Wbf200699-rgb/robei_car/little_car/source_review/57660ad3-9889-42e8-9674-7a41b4bae8d0.png

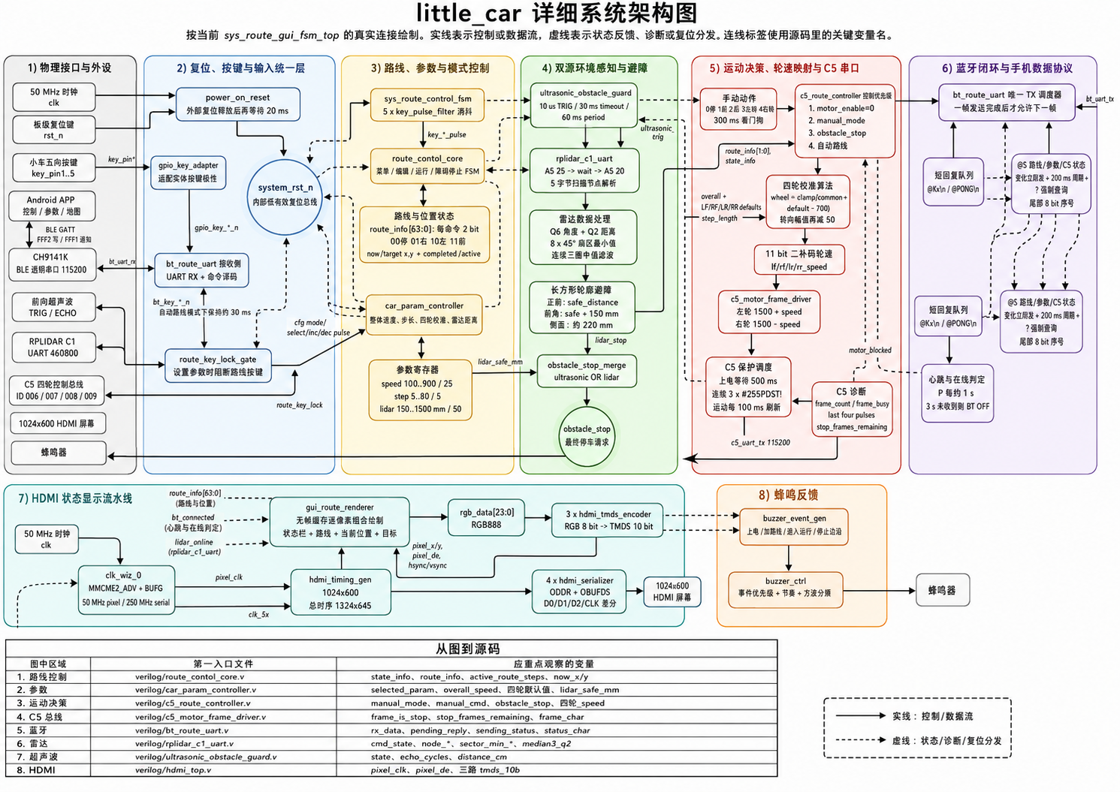
little_car/source_review/57660ad3-9889-42e8-9674-7a41b4bae8d0.png
