Wbf200699-rgb/robei_car/little_car/test_results/uwb_test_telemetry/20260805_123343_live_smoke.report.md

# UWB test telemetry report

> TEST ONLY: this capture is an engineering observation aid. It is not part of the competition architecture, score claim, or vehicle control/safety loop.

## Capture

- Source: `D:\Projects\Robei\little_car_new\little_car\test_results\uwb_test_telemetry\20260805_123343_live_smoke.jsonl`
- Samples: 26
- Duration: 4.999 s
- Effective sample rate: 5.001 Hz
- Gateway connected: 0.0%
- Gateway data fresh: 0.0%
- Four fresh valid tags: 0.0%
- Kinematics-valid samples: 0.0%
- Pose qualities: `{"none": 26}`
- Capture errors: 0 `{}`

## Motion

- Center path length: 0.000 cm
- Start-to-end displacement: 0.000 cm
- Speed median / p95 / max: -- / -- / -- cm/s
- Absolute yaw rate median / p95 / max: -- / -- / -- deg/s
- Fix skew median / p95 / max: -- / -- / -- ms

## Rectangle

| Edge | Median (cm) | P95 (cm) | Samples |
|---|---:|---:|---:|
| Front width | -- | -- | 0 |
| Rear width | -- | -- | 0 |
| Left length | -- | -- | 0 |
| Right length | -- | -- | 0 |

## Tag quality

| Tag | Fresh | Usable | Median X/Y (cm) | RMS radius (cm) | P95 radius (cm) |
|---:|---:|---:|---:|---:|---:|
| 0 | 0.0% | 0.0% | -- / -- | -- | -- |
| 1 | 0.0% | 0.0% | -- / -- | -- | -- |
| 2 | 0.0% | 0.0% | -- / -- | -- | -- |
| 3 | 0.0% | 0.0% | -- / -- | -- | -- |

The radius values are stationary jitter only when the vehicle remained stationary for the entire capture.

## Gateway counters

| Counter | Start | End | Accumulated delta | Resets |
|---|---:|---:|---:|---:|
| `good_frames` | 0 | 0 | 0 | 0 |
| `crc_errors` | 0 | 0 | 0 | 0 |
| `uwb_tx` | 1801 | 1801 | 0 | 0 |
| `queue_drops` | 0 | 0 | 0 | 0 |
| `rx_bytes` | 1 | 1 | 0 | 0 |
| `framing_errors` | 0 | 0 | 0 | 0 |
| `position_frames` | 0 | 0 | 0 | 0 |
| `pass_frames` | 0 | 0 | 0 | 0 |
| `raw_frames` | 0 | 0 | 0 | 0 |
| `position_start_requests` | 1801 | 1801 | 0 | 0 |

## Warnings

- Capture is shorter than 10 seconds; quality statistics are only a smoke test.
- At least one sample did not contain four fresh position-valid tag fixes.
