Wbf200699-rgb/robei_car/docs/FEATURE_STATUS.md

# 功能与验证边界

此页描述当前展示快照。旧文档保留原始实验语境，与此页不一致时以当前源码、`CURRENT_PROJECT_SCOPE.md` 和最新证据为准。

| 范围 | 仓库中已有内容 | 仍需确认 |
| --- | --- | --- |
| 手动/路线控制 | FPGA、BLE App、C5 映射与状态机测试 | 当前整车的按键、急停、看门狗实测 |
| RPLIDAR 与超声波 | UART/测距 RTL、扇区判断、参数仿真与波形 | 环境噪声、供电、电机振动下的可靠性 |
| 雷达地图 | 72 个角度栅格、六段 CRC 协议、占用栅格与匹配参考实现 | 真实长距离定位与累计误差 |
| HDMI | TMDS/时序与渲染模型、历史资源记录 | 当前硬件时钟约束和完整时序收敛 |
| PMW3901 / 双 BMI088 | 初始化、采样、融合、静态标定；历史独立固件实物记录 | 动态轴向/尺度标定与整车闭环表现 |
| UWB | ESP32-S3 网关、服务器、四标签估计与新鲜度检测 | 场地配置、外参、同步和 RF 精度 |
| SD/Flash | 存储模型、测试、诊断固件与历史记录 | 当前接线及掉电恢复的整车测试 |
| VL53L1X 五路 | 非活跃兼容包装和历史材料 | 当前车辆不使用，不列入交付功能 |

## 验证证据怎么读

- `docs/HARDWARE_PARAMETER_SIMULATION.md` 和 `little_car/test/results/hardware_parameters`：RTL 参数/协议证据。
- `docs/experiment_evidence`：2026 年 7 月的 C5/参数实验归档。
- `docs/MOTION_SENSOR_VALIDATION_2026-08-04.md`：独立运动传感器固件的历史实物记录，不能外推成主车全功能验证。
- `docs/VALIDATION_GEOMETRY_CALIBRATION_VL53.md`：历史阶段记录，包含已退休 VL53 内容及未约束时钟的说明，不用于当前启用功能或时序收敛宣传。
- `docs/VALIDATION.md`：本次整理实际执行的检查。

没有新实测数据时，不在简历中写定位精度、成功率、续航、速度误差、整车时序收敛或可靠性百分比。历史报告的数字必须连同日期、版本和测试条件引用。
