Wbf200699-rgb/robei_car/docs/media/README.md

# 待补充的本人演示材料

放入本人确认可公开的实物照片、App 截图和波形截图，再在首页引用。当前未提供实物图片，不使用生成图片替代实物证据。

建议：整车全景、FPGA/传感器接线、连接与雷达页面、标定估值更新、波形关键跳变。截图前移除设备地址、Token 和个人通知。

该目录默认忽略新媒体文件，审核后使用 `git add -f docs/media/<文件>` 添加。
