Wbf200699-rgb/robei_car/docs/PROVENANCE.md

# 整理说明与代码来源

## 来源快照

- 上游工程：`meguminawa-vrc/little_car_new`（原仓库为私有）。
- 基础提交：`3640cea2811982ce9fee324b28e113d558ef0698`，`Fix destination selection and map feedback`。
- 整理日期：2026-10-14。
- 发布目标：`Wbf200699-rgb/robei_car`。

按用户要求整理工程用于简历展示。原工作区路径已不存在；本次发现的三份本地 App 都是 2026-07-11 的相同旧快照，因此采用可访问的最新完整上游源码。不能据此声称此前未提交改动全部进入本版。

本展示仓库不复制上游私有 Git 历史，不更改上游仓库。当前版本是保留来源说明的新整理快照，不能据此推断各模块作者或个人贡献比例。文档和部分工具含 AI 辅助整理，需按实际参与情况表述简历。作者确认本项目为其集创赛全国二等奖作品；届次、赛道和分工未单独提供。

## 保留

- FPGA/Robei 模型、约束、测试、诊断源码和阅读导出器。
- Android App、ESP32-S3 固件、FastAPI 服务和配置模板。
- 协议、几何来源及历史实验材料。
- 小型 VCD、测试日志、CSV 和哈希清单。

## 整理

- 增加中文首页、架构、复现、功能边界、演示及简历表达参考。
- 增加发布检查与 CI，修复仿真工具和 FPGA 构建入口的路径依赖。
- 将公开展示版的现网 UWB 服务地址替换为 `relay.example.invalid` 占位符。
- 将原生开发工程的供应商仿真库注册项清空，芯片原语由安装工具提供；精简 Robei 工程继续作为推荐入口。

## 排除

- `little_car/verilog` 中约 100 MB 的 Xilinx 工具附带仿真库：由工具环境提供，不作为个人项目源码重新发布。
- `little_car/backup`、`little_car/change`：旧工程快照不进入展示版。
- 根目录空占位文件 `app`。
- `.git`、本机配置、密钥、编译缓存、APK、bitstream 与调试临时文件。

## 历史材料

历史文档可能描述过时硬件、旧目录和当时尚未完成的工作，保留是为了追溯，不是当前完成度承诺。首页以 `FEATURE_STATUS.md` 为功能边界。涉及芯片原语、Gradle Wrapper 等第三方内容见根目录 `THIRD_PARTY_NOTICES.md`。
