Wbf200699-rgb/robei_car/docs/figures/path_control_main_fsm/path_control_main_fsm.png

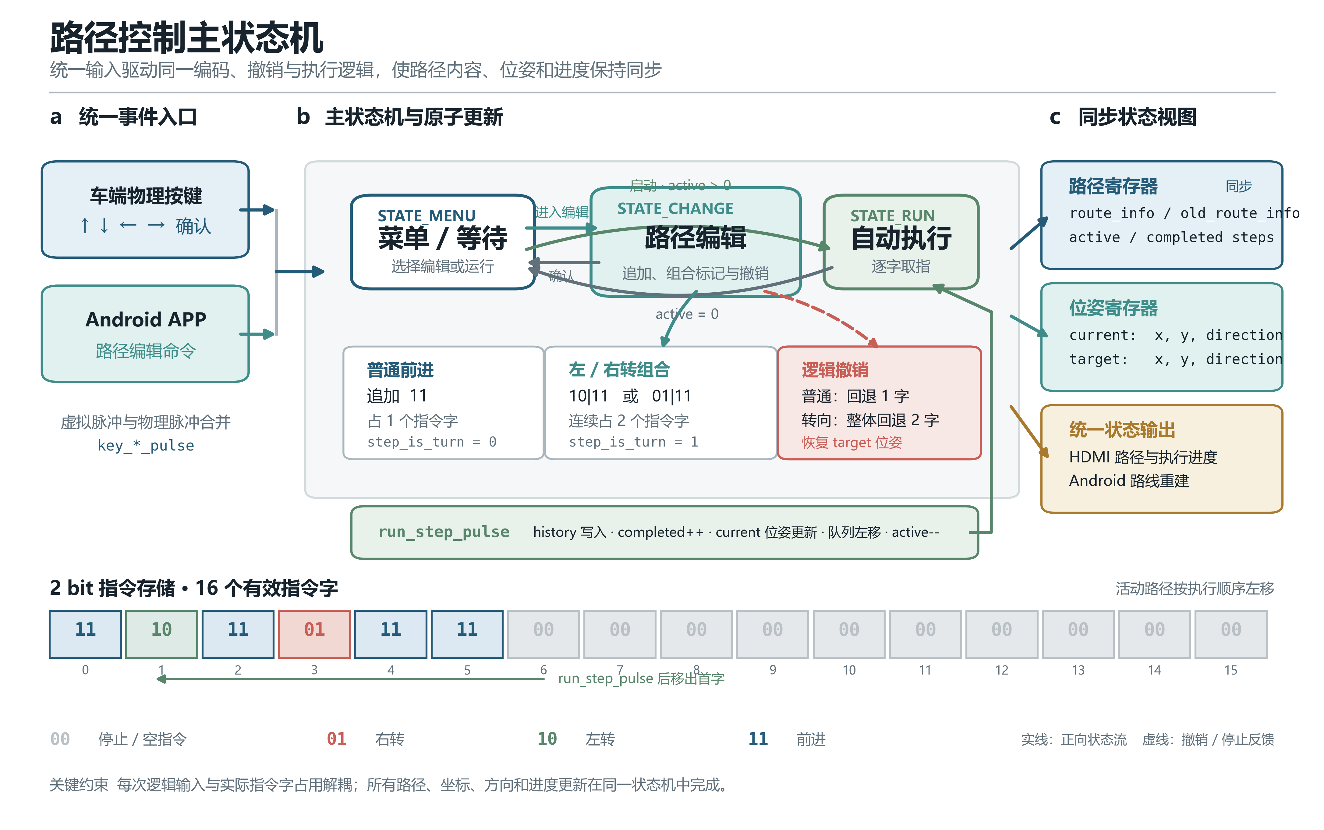
docs/figures/path_control_main_fsm/path_control_main_fsm.png
