Wbf200699-rgb/robei_car/little_car/source_review/module_manifest.csv

module | model_file | source_scope | ports | instances | wires | code_lines | output_file | child_classes
hdmi_timing_gen | hdmi_timing_gen.model | project | 7 | 0 | 0 | 29 | hdmi_timing_gen.v
hdmi_tmds_encoder | hdmi_tmds_encoder.model | project | 7 | 0 | 0 | 59 | hdmi_tmds_encoder.v
hdmi_serializer | hdmi_serializer.model | project | 6 | 0 | 0 | 86 | hdmi_serializer.v
hdmi_pixel_shader | hdmi_pixel_shader.model | project | 6 | 0 | 0 | 21 | hdmi_pixel_shader.v
hdmi_top | hdmi_top.model | project | 15 | 11 | 52 | 4 | hdmi_top.v | clk_wiz_0 hdmi_const hdmi_rgb_splitter hdmi_serializer hdmi_timing_gen hdmi_tmds_encoder
clk_wiz_0 | clk_wiz_0.model | project | 5 | 0 | 0 | 123 | clk_wiz_0.v
hdmi_const | hdmi_const.model | project | 2 | 0 | 0 | 2 | hdmi_const.v
hdmi_rgb_splitter | hdmi_rgb_splitter.model | project | 5 | 0 | 0 | 3 | hdmi_rgb_splitter.v
gui_route_renderer | gui_route_renderer.model | project | 22 | 0 | 0 | 1031 | gui_route_renderer.v
gui_route_test_top | gui_route_test_top.model | project | 10 | 5 | 32 | 0 | gui_route_test_top.v | gui_menu_to_state_info gui_route_demo_info_source gui_route_renderer hdmi_top temp_gui_status_source
gui_route_demo_info_source | gui_route_demo_info_source.model | project | 2 | 0 | 0 | 10 | gui_route_demo_info_source.v
key_pulse_filter | key_pulse_filter.model | project | 4 | 0 | 0 | 32 | key_pulse_filter.v
sys_route_control_fsm | sys_route_control_fsm.model | project | 26 | 6 | 41 | 0 | sys_route_control_fsm.v | key_pulse_filter route_contol_core
sys_route_control_core | sys_route_control_core.model | project | 26 | 0 | 0 | 230 | sys_route_control_core.v
sys_route_gui_fsm_top | sys_route_gui_fsm_top.model | project | 27 | 23 | 189 | 1 | sys_route_gui_fsm_top.v | bt_route_uart buzzer_ctrl buzzer_event_gen c5_motor_frame_driver c5_motor_test_pattern c5_route_controller car_param_controller gpio_key_adapter gui_route_renderer hdmi_top key_low_merge linkpg_uwb_bridge obstacle_stop_merge power_on_reset route_key_lock_gate rplidar_c1_uart sys_route_control_fsm temp_c5_motor_config_source temp_key_gpio_config_source temp_run_status_source temp_ultrasonic_echo_source temp_ultrasonic_enable_source ultrasonic_obstacle_guard
gui_menu_to_state_info | gui_menu_to_state_info.model | project | 2 | 0 | 0 | 7 | gui_menu_to_state_info.v
temp_gui_status_source | temp_gui_status_source.model | project | 12 | 0 | 0 | 12 | temp_gui_status_source.v
temp_run_status_source | temp_run_status_source.model | project | 4 | 0 | 0 | 4 | temp_run_status_source.v
ultrasonic_obstacle_guard | ultrasonic_obstacle_guard.model | project | 10 | 0 | 0 | 170 | ultrasonic_obstacle_guard.v
temp_ultrasonic_echo_source | temp_ultrasonic_echo_source.model | project | 5 | 0 | 0 | 99 | temp_ultrasonic_echo_source.v
temp_ultrasonic_enable_source | temp_ultrasonic_enable_source.model | project | 1 | 0 | 0 | 1 | temp_ultrasonic_enable_source.v
motor_encoder_interface | motor_encoder_interface.model | project | 22 | 0 | 0 | 105 | motor_encoder_interface.v
motor_route_controller | motor_route_controller.model | project | 29 | 0 | 0 | 172 | motor_route_controller.v
motor_tb6612_driver | motor_tb6612_driver.model | project | 25 | 0 | 0 | 61 | motor_tb6612_driver.v
temp_motor_config_source | temp_motor_config_source.model | project | 5 | 0 | 0 | 5 | temp_motor_config_source.v
gpio_key_adapter | gpio_key_adapter.model | project | 11 | 0 | 0 | 17 | gpio_key_adapter.v
key_low_merge | key_low_merge.model | project | 15 | 0 | 0 | 5 | key_low_merge.v
temp_key_gpio_config_source | temp_key_gpio_config_source.model | project | 1 | 0 | 0 | 1 | temp_key_gpio_config_source.v
buzzer_ctrl | buzzer_ctrl.model | project | 7 | 0 | 0 | 88 | buzzer_ctrl.v
buzzer_event_gen | buzzer_event_gen.model | project | 8 | 0 | 0 | 23 | buzzer_event_gen.v
bt_route_uart | bt_route_uart.model | project | 64 | 0 | 0 | 977 | bt_route_uart.v
uart_tx_8n1 | uart_tx_8n1.model | project | 6 | 0 | 0 | 81 | uart_tx_8n1.v
c5_motor_frame_driver | c5_motor_frame_driver.model | project | 17 | 0 | 0 | 397 | c5_motor_frame_driver.v
c5_motor_test_pattern | c5_motor_test_pattern.model | project | 6 | 0 | 0 | 44 | c5_motor_test_pattern.v
c5_route_controller | c5_route_controller.model | project | 27 | 0 | 0 | 235 | c5_route_controller.v
temp_c5_motor_config_source | temp_c5_motor_config_source.model | project | 5 | 0 | 0 | 5 | temp_c5_motor_config_source.v
car_param_controller | car_param_controller.model | project | 25 | 0 | 0 | 143 | car_param_controller.v
route_key_lock_gate | route_key_lock_gate.model | project | 11 | 0 | 0 | 5 | route_key_lock_gate.v
rplidar_c1_uart | rplidar_c1_uart.model | project | 24 | 0 | 0 | 551 | rplidar_c1_uart.v
obstacle_stop_merge | obstacle_stop_merge.model | project | 3 | 0 | 0 | 1 | obstacle_stop_merge.v
power_on_reset | power_on_reset.model | project | 3 | 0 | 0 | 21 | power_on_reset.v
motion_sensor_subsystem | motion_sensor_subsystem.model | project | 38 | 0 | 0 | 1342 | motion_sensor_subsystem.v
motion_sensor_bringup_top | motion_sensor_bringup_top.model | project | 14 | 0 | 0 | 72 | motion_sensor_bringup_top.v
linkpg_uwb_bridge | linkpg_uwb_bridge.model | project | 12 | 0 | 0 | 1029 | linkpg_uwb_bridge.v
route_contol_core | route_contol_core.model | dependency | 26 | 0 | 0 | 237 | route_contol_core.v
