Wbf200699-rgb/robei_car/docs/UWB_DEVICE_INVENTORY.md

# LinkPG 设备配置盘点

本文件只记录通过 Modbus 只读寄存器得到的配置。未实际读取的设备不作
推断。探测工具为 `tools/linkpg_config_probe.py`。

| 物理标签 | 协议 ID | 角色 | 测距方式 | 定位模式 | 信道编码 | 速率编码 | 状态 |
| --- | ---: | --- | --- | --- | ---: | ---: | --- |
| 标签 0 | 0 | 标签 | HDS-TWR | 一对一 | 0 | 1 | 已确认 |
| 标签 1 | 1 | 标签 | HDS-TWR | 一对一 | 0 | 1 | 已确认 |
| 标签 2 | 2 | 标签 | HDS-TWR | 一对一 | 0 | 1 | 已确认 |
| 标签 3 | 3 | 标签 | HDS-TWR | 一对一 | 0 | 1 | 已确认 |

| 物理基站 | 协议角色/ID | 测距方式 | 定位模式 | 信道/速率编码 | 坐标 cm | 状态 |
| --- | --- | --- | --- | --- | --- | --- |
| A | 主基站 | HDS-TWR | 二维 | 0/1 | 0,0,0 | 已写入并回读 |
| B | 次基站 B | HDS-TWR | 由主基站调度 | 0/1 | 150,0,0 | 坐标已写入主基站；本机未直读 |
| C | 次基站 C | HDS-TWR | 由主基站调度 | 0/1 | 150,170,0 | 坐标已写入主基站；本机未直读 |
| D | 次基站 D | HDS-TWR | 由主基站调度 | 0/1 | 0,170,0 | 坐标已写入主基站；本机未直读 |

主基站 A 当前还配置了：A-D 使能、持续自动输出、硬件解算开启、标签数
4、标签列表 0/1/2/3、输出坐标和距离。矩形按 A 左上、B 右上、C 右下、
D 左下定义，坐标系采用 X 向右、Y 向下。AB 实测约 150 cm，BC 暂按约
170 cm 配置；正式精度测试前应重新测量四根天线中心之间的实际距离。

2026-08-04 配置后直接从主基站 USB 采样 5 秒，共收到 219 个 CRC 正确的
定位帧。标签 0/1/2/3 均返回定位有效位，且 A-D 四基站测距成功掩码均为
`0x000F`。配置前后快照和采样摘要保存在 `docs/uwb_config_evidence/`。

四块物理标签均已直接读取确认，并且主基站均能收到其测距帧。当前四块
标签为随机摆放，没有车体角点语义；安装完成后再记录左前/右前/左后/
右后对应 ID，并同步修改服务器。
