Wbf200699-rgb/robei_car/little_car/test_results/uwb_test_telemetry/20260805_123343_live_smoke.csv

sample_index | captured_at_unix | elapsed_s | gateway_connected | gateway_data_fresh | gateway_status_age_ms | position_frames | crc_errors | framing_errors | pose_quality | pose_x_cm | pose_y_cm | pose_heading_deg | fix_skew_ms | front_width_cm | rear_width_cm | left_length_cm | right_length_cm | fresh_tag_count | kinematics_valid | vx_cm_s | vy_cm_s | speed_cm_s | yaw_rate_deg_s | tag0_fresh | tag0_valid | tag0_age_ms | tag0_x_cm | tag0_y_cm | tag0_z_cm | tag0_distance_a_cm | tag0_distance_b_cm | tag0_distance_c_cm | tag0_distance_d_cm | tag1_fresh | tag1_valid | tag1_age_ms | tag1_x_cm | tag1_y_cm | tag1_z_cm | tag1_distance_a_cm | tag1_distance_b_cm | tag1_distance_c_cm | tag1_distance_d_cm | tag2_fresh | tag2_valid | tag2_age_ms | tag2_x_cm | tag2_y_cm | tag2_z_cm | tag2_distance_a_cm | tag2_distance_b_cm | tag2_distance_c_cm | tag2_distance_d_cm | tag3_fresh | tag3_valid | tag3_age_ms | tag3_x_cm | tag3_y_cm | tag3_z_cm
0 | 1785904423.5719326 | 0.001004934310913086 | False | False | 1150203.0420303345 | 0 | 0 | 0 | none |  |  |  |  |  |  |  |  | 0 | False |  |  |  |  |  |  |  |  |  |  |  |  |  |  |  |  |  |  |  |  |  |  |  |  |  |  |  |  |  |  |  |  |  |  | False | False | 18573088.354349136 | 0 | 0 | 0
1 | 1785904423.763543 | 0.19261527061462402 | False | False | 1150299.7982501984 | 0 | 0 | 0 | none |  |  |  |  |  |  |  |  | 0 | False |  |  |  |  |  |  |  |  |  |  |  |  |  |  |  |  |  |  |  |  |  |  |  |  |  |  |  |  |  |  |  |  |  |  | False | False | 18573185.110569 | 0 | 0 | 0
2 | 1785904423.967433 | 0.39650535583496094 | False | False | 1150493.7000274658 | 0 | 0 | 0 | none |  |  |  |  |  |  |  |  | 0 | False |  |  |  |  |  |  |  |  |  |  |  |  |  |  |  |  |  |  |  |  |  |  |  |  |  |  |  |  |  |  |  |  |  |  | False | False | 18573379.012346268 | 0 | 0 | 0
3 | 1785904424.171722 | 0.6007943153381348 | False | False | 1150722.0242023468 | 0 | 0 | 0 | none |  |  |  |  |  |  |  |  | 0 | False |  |  |  |  |  |  |  |  |  |  |  |  |  |  |  |  |  |  |  |  |  |  |  |  |  |  |  |  |  |  |  |  |  |  | False | False | 18573607.33652115 | 0 | 0 | 0
4 | 1785904424.3666122 | 0.7956845760345459 | False | False | 1150890.105009079 | 0 | 0 | 0 | none |  |  |  |  |  |  |  |  | 0 | False |  |  |  |  |  |  |  |  |  |  |  |  |  |  |  |  |  |  |  |  |  |  |  |  |  |  |  |  |  |  |  |  |  |  | False | False | 18573775.41732788 | 0 | 0 | 0
5 | 1785904424.561724 | 0.9907963275909424 | False | False | 1151107.9578399658 | 0 | 0 | 0 | none |  |  |  |  |  |  |  |  | 0 | False |  |  |  |  |  |  |  |  |  |  |  |  |  |  |  |  |  |  |  |  |  |  |  |  |  |  |  |  |  |  |  |  |  |  | False | False | 18573993.270158768 | 0 | 0 | 0
6 | 1785904424.7626722 | 1.1917445659637451 | False | False | 1151284.484386444 | 0 | 0 | 0 | none |  |  |  |  |  |  |  |  | 0 | False |  |  |  |  |  |  |  |  |  |  |  |  |  |  |  |  |  |  |  |  |  |  |  |  |  |  |  |  |  |  |  |  |  |  | False | False | 18574169.796705246 | 0 | 0 | 0
7 | 1785904424.967662 | 1.3967344760894775 | False | False | 1151493.5894012451 | 0 | 0 | 0 | none |  |  |  |  |  |  |  |  | 0 | False |  |  |  |  |  |  |  |  |  |  |  |  |  |  |  |  |  |  |  |  |  |  |  |  |  |  |  |  |  |  |  |  |  |  | False | False | 18574378.901720047 | 0 | 0 | 0
8 | 1785904425.1711218 | 1.6001942157745361 | False | False | 1151713.7761116028 | 0 | 0 | 0 | none |  |  |  |  |  |  |  |  | 0 | False |  |  |  |  |  |  |  |  |  |  |  |  |  |  |  |  |  |  |  |  |  |  |  |  |  |  |  |  |  |  |  |  |  |  | False | False | 18574599.088430405 | 0 | 0 | 0
9 | 1785904425.3607852 | 1.7898576259613037 | False | False | 1151884.4728469849 | 0 | 0 | 0 | none |  |  |  |  |  |  |  |  | 0 | False |  |  |  |  |  |  |  |  |  |  |  |  |  |  |  |  |  |  |  |  |  |  |  |  |  |  |  |  |  |  |  |  |  |  | False | False | 18574769.785165787 | 0 | 0 | 0
10 | 1785904425.5724468 | 2.001519203186035 | False | False | 1152096.506357193 | 0 | 0 | 0 | none |  |  |  |  |  |  |  |  | 0 | False |  |  |  |  |  |  |  |  |  |  |  |  |  |  |  |  |  |  |  |  |  |  |  |  |  |  |  |  |  |  |  |  |  |  | False | False | 18574981.818675995 | 0 | 0 | 0
11 | 1785904425.7655551 | 2.194627523422241 | False | False | 1152303.3361434937 | 0 | 0 | 0 | none |  |  |  |  |  |  |  |  | 0 | False |  |  |  |  |  |  |  |  |  |  |  |  |  |  |  |  |  |  |  |  |  |  |  |  |  |  |  |  |  |  |  |  |  |  | False | False | 18575188.648462296 | 0 | 0 | 0
12 | 1785904425.9693155 | 2.398387908935547 | False | False | 1152505.3141117096 | 0 | 0 | 0 | none |  |  |  |  |  |  |  |  | 0 | False |  |  |  |  |  |  |  |  |  |  |  |  |  |  |  |  |  |  |  |  |  |  |  |  |  |  |  |  |  |  |  |  |  |  | False | False | 18575390.62643051 | 0 | 0 | 0
13 | 1785904426.1707468 | 2.5998191833496094 | False | False | 1152695.7614421844 | 0 | 0 | 0 | none |  |  |  |  |  |  |  |  | 0 | False |  |  |  |  |  |  |  |  |  |  |  |  |  |  |  |  |  |  |  |  |  |  |  |  |  |  |  |  |  |  |  |  |  |  | False | False | 18575581.073760986 | 0 | 0 | 0
14 | 1785904426.371008 | 2.8000802993774414 | False | False | 1152896.151304245 | 0 | 0 | 0 | none |  |  |  |  |  |  |  |  | 0 | False |  |  |  |  |  |  |  |  |  |  |  |  |  |  |  |  |  |  |  |  |  |  |  |  |  |  |  |  |  |  |  |  |  |  | False | False | 18575781.463623047 | 0 | 0 | 0
15 | 1785904426.569229 | 2.9983012676239014 | False | False | 1153089.7648334503 | 0 | 0 | 0 | none |  |  |  |  |  |  |  |  | 0 | False |  |  |  |  |  |  |  |  |  |  |  |  |  |  |  |  |  |  |  |  |  |  |  |  |  |  |  |  |  |  |  |  |  |  | False | False | 18575975.077152252 | 0 | 0 | 0
16 | 1785904426.7583964 | 3.1874687671661377 | False | False | 1153288.8855934143 | 0 | 0 | 0 | none |  |  |  |  |  |  |  |  | 0 | False |  |  |  |  |  |  |  |  |  |  |  |  |  |  |  |  |  |  |  |  |  |  |  |  |  |  |  |  |  |  |  |  |  |  | False | False | 18576174.197912216 | 0 | 0 | 0
17 | 1785904426.9712646 | 3.400336980819702 | False | False | 1153491.7759895325 | 0 | 0 | 0 | none |  |  |  |  |  |  |  |  | 0 | False |  |  |  |  |  |  |  |  |  |  |  |  |  |  |  |  |  |  |  |  |  |  |  |  |  |  |  |  |  |  |  |  |  |  | False | False | 18576377.088308334 | 0 | 0 | 0
18 | 1785904427.171295 | 3.600367307662964 | False | False | 1153697.740316391 | 0 | 0 | 0 | none |  |  |  |  |  |  |  |  | 0 | False |  |  |  |  |  |  |  |  |  |  |  |  |  |  |  |  |  |  |  |  |  |  |  |  |  |  |  |  |  |  |  |  |  |  | False | False | 18576583.052635193 | 0 | 0 | 0
19 | 1785904427.3586102 | 3.78768253326416 | False | False | 1153883.0208778381 | 0 | 0 | 0 | none |  |  |  |  |  |  |  |  | 0 | False |  |  |  |  |  |  |  |  |  |  |  |  |  |  |  |  |  |  |  |  |  |  |  |  |  |  |  |  |  |  |  |  |  |  | False | False | 18576768.33319664 | 0 | 0 | 0
20 | 1785904427.5702093 | 3.999281644821167 | False | False | 1154094.8600769043 | 0 | 0 | 0 | none |  |  |  |  |  |  |  |  | 0 | False |  |  |  |  |  |  |  |  |  |  |  |  |  |  |  |  |  |  |  |  |  |  |  |  |  |  |  |  |  |  |  |  |  |  | False | False | 18576980.172395706 | 0 | 0 | 0
21 | 1785904427.7657235 | 4.194795846939087 | False | False | 1154305.721282959 | 0 | 0 | 0 | none |  |  |  |  |  |  |  |  | 0 | False |  |  |  |  |  |  |  |  |  |  |  |  |  |  |  |  |  |  |  |  |  |  |  |  |  |  |  |  |  |  |  |  |  |  | False | False | 18577191.03360176 | 0 | 0 | 0
22 | 1785904427.9715269 | 4.400599241256714 | False | False | 1154494.7934150696 | 0 | 0 | 0 | none |  |  |  |  |  |  |  |  | 0 | False |  |  |  |  |  |  |  |  |  |  |  |  |  |  |  |  |  |  |  |  |  |  |  |  |  |  |  |  |  |  |  |  |  |  | False | False | 18577380.10573387 | 0 | 0 | 0
23 | 1785904428.1585364 | 4.587608814239502 | False | False | 1154683.7284564972 | 0 | 0 | 0 | none |  |  |  |  |  |  |  |  | 0 | False |  |  |  |  |  |  |  |  |  |  |  |  |  |  |  |  |  |  |  |  |  |  |  |  |  |  |  |  |  |  |  |  |  |  | False | False | 18577569.0407753 | 0 | 0 | 0
24 | 1785904428.3599696 | 4.789041996002197 | False | False | 1154897.6247310638 | 0 | 0 | 0 | none |  |  |  |  |  |  |  |  | 0 | False |  |  |  |  |  |  |  |  |  |  |  |  |  |  |  |  |  |  |  |  |  |  |  |  |  |  |  |  |  |  |  |  |  |  | False | False | 18577782.937049866 | 0 | 0 | 0
25 | 1785904428.5704644 | 4.999536752700806 | False | False | 1155093.61410141 | 0 | 0 | 0 | none |  |  |  |  |  |  |  |  | 0 | False |  |  |  |  |  |  |  |  |  |  |  |  |  |  |  |  |  |  |  |  |  |  |  |  |  |  |  |  |  |  |  |  |  |  | False | False | 18577978.92642021 | 0 | 0 | 0
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
