Wbf200699-rgb/robei_car/little_car/test_results/uwb_test_telemetry/20260805_123436_csv_schema_smoke.csv

schema | test_only | competition_design_input | label | sample_index | captured_at_unix | elapsed_s | gateway_connected | gateway_data_fresh | gateway_status_age_ms | position_frames | crc_errors | framing_errors | pose_quality | pose_x_cm | pose_y_cm | pose_heading_deg | fix_skew_ms | front_width_cm | rear_width_cm | left_length_cm | right_length_cm | fresh_tag_count | kinematics_valid | vx_cm_s | vy_cm_s | speed_cm_s | yaw_rate_deg_s | tag0_fresh | tag0_valid | tag0_age_ms | tag0_x_cm | tag0_y_cm | tag0_z_cm | tag0_distance_a_cm | tag0_distance_b_cm | tag0_distance_c_cm | tag0_distance_d_cm | tag1_fresh | tag1_valid | tag1_age_ms | tag1_x_cm | tag1_y_cm | tag1_z_cm | tag1_distance_a_cm | tag1_distance_b_cm | tag1_distance_c_cm | tag1_distance_d_cm | tag2_fresh | tag2_valid | tag2_age_ms | tag2_x_cm | tag2_y_cm | tag2_z_cm | tag2_distance_a_cm | tag2_distance_b_cm | tag2_distance_c_cm | tag2_distance_d_cm | tag3_fresh | tag3_valid
little_car_uwb_test_v1 | True | False | csv_schema_smoke | 0 | 1785904476.8495872 | 0.0010013580322265625 | False | False | 1203445.0645446777 | 0 | 0 | 0 | none |  |  |  |  |  |  |  |  | 0 | False |  |  |  |  |  |  |  |  |  |  |  |  |  |  |  |  |  |  |  |  |  |  |  |  |  |  |  |  |  |  |  |  |  |  | False | False
little_car_uwb_test_v1 | True | False | csv_schema_smoke | 1 | 1785904477.0542183 | 0.20563244819641113 | False | False | 1203576.814174652 | 0 | 0 | 0 | none |  |  |  |  |  |  |  |  | 0 | False |  |  |  |  |  |  |  |  |  |  |  |  |  |  |  |  |  |  |  |  |  |  |  |  |  |  |  |  |  |  |  |  |  |  | False | False
little_car_uwb_test_v1 | True | False | csv_schema_smoke | 2 | 1785904477.24208 | 0.3934941291809082 | False | False | 1203788.6309623718 | 0 | 0 | 0 | none |  |  |  |  |  |  |  |  | 0 | False |  |  |  |  |  |  |  |  |  |  |  |  |  |  |  |  |  |  |  |  |  |  |  |  |  |  |  |  |  |  |  |  |  |  | False | False
little_car_uwb_test_v1 | True | False | csv_schema_smoke | 3 | 1785904477.4517357 | 0.6031498908996582 | False | False | 1203996.6313838959 | 0 | 0 | 0 | none |  |  |  |  |  |  |  |  | 0 | False |  |  |  |  |  |  |  |  |  |  |  |  |  |  |  |  |  |  |  |  |  |  |  |  |  |  |  |  |  |  |  |  |  |  | False | False
little_car_uwb_test_v1 | True | False | csv_schema_smoke | 4 | 1785904477.6408362 | 0.792250394821167 | False | False | 1204166.9013500214 | 0 | 0 | 0 | none |  |  |  |  |  |  |  |  | 0 | False |  |  |  |  |  |  |  |  |  |  |  |  |  |  |  |  |  |  |  |  |  |  |  |  |  |  |  |  |  |  |  |  |  |  | False | False
little_car_uwb_test_v1 | True | False | csv_schema_smoke | 5 | 1785904477.8548217 | 1.0062358379364014 | False | False | 1204380.0776004791 | 0 | 0 | 0 | none |  |  |  |  |  |  |  |  | 0 | False |  |  |  |  |  |  |  |  |  |  |  |  |  |  |  |  |  |  |  |  |  |  |  |  |  |  |  |  |  |  |  |  |  |  | False | False
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
