Wbf200699-rgb/robei_car/docs/current_wiring.xlsx

Sheet: 总览
little_car 当前完整接线总览
分类 | 状态 | 说明
约束来源 | 已生效 | 当前主工程以 little_car/build/top.xdc 为准；本工作簿按该文件和顶层HDL核对。
主工程外接线 | 已生效 | C5底盘、RPLIDAR C1、超声波和HDMI，见“主工程外接线”。
板载接口 | 板载 | CH9141K、五向键、蜂鸣器、复位、时钟和HDMI TMDS均由板上走线连接。
PMW3901 + 双BMI088 | 独立固件 | 只在 motion_sensor_bringup_top.bit 中生效，尚未并入小车主固件。
四标签UWB | 预留/未集成 | H3-17至H3-20仅为规划接收脚；当前主工程没有UWB顶层端口、约束或解析逻辑。
接口兼容性 | 预留/未集成 | 运动传感器使用H3-1至H3-14，UWB预留H3-17至H3-20，物理针脚不冲突，但当前不是同一固件。
UART方向 | 必接 | 所有UART均交叉连接：设备TX接FPGA RX，FPGA TX接设备RX。
逻辑电平 | 警告 | FPGA GPIO均为3.3V LVCMOS33；任何5V输出进入FPGA前必须分压或电平转换。
公共地 | 必接 | 与FPGA有UART、SPI或脉冲信号连接的设备必须和FPGA共地。
大功率供电 | 禁止 | 雷达、UWB、电机和屏幕不得从FPGA扩展口VCC供电。
操作顺序 | 必接 | 断电接线→万用表确认电压→先接地→再接信号→最后上电；逐个子系统验证。

Sheet: 主工程外接线
当前主工程外部接线
设备 | 设备端 | FPGA接口 | FPGA封装脚 | HDL信号 | 信号方向 | 参数/电平 | 接线要求 | 代码状态 | 备注
C5底盘控制器 | UART RX / DATA输入 | H4-3 | R14 | c5_uart_tx | FPGA → C5 | 115200, 8N1, 3.3V逻辑 | 必接 | 已生效 | 当前四轮控制命令输出
C5底盘控制器 | UART TX回传 | H4-6 | P15 | c5_uart_rx | C5 → FPGA | 输入必须≤3.3V | 可选 | 预留/未集成 | 顶层有端口和约束，但当前HDL不解析该输入
C5底盘控制器 | GND | H4-14或H4-15 | GND | — | 公共参考地 | 0V | 必接 | 已生效 | 与底盘控制器共地；电机大电流不经杜邦线
C5底盘/电机 | 电源 | 不接FPGA VCC | — | — | 供电 | 底盘原电池/驱动电源 | 必接 | 已生效 | 保持原套件电机与控制器接线
RPLIDAR C1 | TXD | H2-12 | K17 | lidar_uart_rx | 雷达 → FPGA | 460800, 8N1, 输入≤3.3V | 必接 | 已生效 | 雷达测距数据输入
RPLIDAR C1 | RXD | H2-11 | J17 | lidar_uart_tx | FPGA → 雷达 | 460800, 8N1, 3.3V逻辑 | 必接 | 已生效 | 启动、停止和扫描命令输出
RPLIDAR C1 | 5V | 外部稳压5V | — | — | 供电 | 按模块标识使用稳定5V | 必接 | 已生效 | 不要从FPGA扩展口VCC取电
RPLIDAR C1 | GND | H2-14或H2-15 | GND | — | 公共参考地 | 0V | 必接 | 已生效 | 外部5V负极与FPGA GND单点相连
超声波模块 | TRIG | H2-26 | E22 | ultrasonic_trig | FPGA → 超声波 | 3.3V脉冲输出 | 必接 | 已生效 | 触发测距
超声波模块 | ECHO | H2-27 | D21 | ultrasonic_echo | 超声波 → FPGA | 输入必须≤3.3V | 必接 | 已生效 | 若ECHO为5V：10k串联、D21到GND接20k分压
超声波模块 | VCC | 外部模块额定电源 | — | — | 供电 | 按模块规格，常见为5V | 必接 | 已生效 | 先确认具体模块电压
超声波模块 | GND | H2-14或H2-15 | GND | — | 公共参考地 | 0V | 必接 | 已生效 | 与FPGA共地
HDMI屏幕 | HDMI输入 | 板载HDMI座 | 板载TMDS脚 | hdmi_* | FPGA → 屏幕 | TMDS经板载连接器 | 必接 | 已生效 | 仅使用标准HDMI线，不接杜邦线
HDMI屏幕 | 电源 | 屏幕额定电源口 | — | — | 供电 | 按屏幕标称电压 | 必接 | 已生效 | 屏幕单独供电，不从FPGA扩展口取电

Sheet: 板载接口
板载接口与无需杜邦线的连接
功能 | 接口/封装脚 | HDL信号 | 方向或动作 | 参数 | 状态 | 是否需要外接 | 备注
CH9141K RX | T21 | bt_uart_tx | FPGA → 蓝牙 | 115200, 8N1 | 板载 | 否 | 当前已经成功验证的TX方向
CH9141K TX | U21 | bt_uart_rx | 蓝牙 → FPGA | 115200, 8N1 | 板载 | 否 | 当前已经成功验证的RX方向
CH9141K AT | U20 | bt_at | FPGA保持高电平 | 正常BLE透传模式 | 板载 | 否 | 不要外接拉低
上键 | H1-1 / J6 | key_pin1 | 按下接地 | 内部上拉、低有效 | 板载 | 通常否 | 外接按键时另一端接GND
左键 | H1-5 / E3 | key_pin2 | 按下接地 | 内部上拉、低有效 | 板载 | 通常否 | 外接按键时另一端接GND
右键 | H1-8 / H3 | key_pin3 | 按下接地 | 内部上拉、低有效 | 板载 | 通常否 | 外接按键时另一端接GND
下键 | H1-4 / J5 | key_pin4 | 按下接地 | 内部上拉、低有效 | 板载 | 通常否 | 外接按键时另一端接GND
中键/确认 | H1-9 / J4 | key_pin5 | 按下接地 | 内部上拉、低有效 | 板载 | 通常否 | 外接按键时另一端接GND
蜂鸣器 | Y8 | buzzer_out | FPGA输出 | LVCMOS33 | 板载 | 否 | 板载蜂鸣器
复位键 | J20 | rst_n | 低有效复位 | 内部上拉 | 板载 | 否 | 板载复位
系统时钟 | Y18 | clk | 板载时钟输入 | 由板卡时钟源提供 | 板载 | 否 | 不要外接时钟
HDMI CLK P/N | C22 / B22 | hdmi_clk_p/n | 板载TMDS | 差分对 | 板载 | 否 | 通过HDMI座输出
HDMI D0 P/N | B21 / A21 | hdmi_d0_p/n | 板载TMDS | 差分对 | 板载 | 否 | 通过HDMI座输出
HDMI D1 P/N | B20 / A20 | hdmi_d1_p/n | 板载TMDS | 差分对 | 板载 | 否 | 通过HDMI座输出
HDMI D2 P/N | A18 / A19 | hdmi_d2_p/n | 板载TMDS | 差分对 | 板载 | 否 | 通过HDMI座输出

Sheet: 运动传感器
PMW3901与双BMI088独立验证固件接线
H3针脚 | FPGA封装脚 | 总线/片选 | 连接到PMW3901 | 连接到BMI088 #0 | 连接到BMI088 #1 | 电平 | 状态 | 备注
H3-1 | A14 | 共享SCLK | SCLK | SCK | SCK | 3.3V | 独立固件 | SPI Mode 3，线长建议小于15cm
H3-2 | B15 | 共享MOSI | MOSI / SDI | SDI | SDI | 3.3V | 独立固件 | 三块模块共用
H3-3 | A13 | 共享MISO | MISO / SDO | SDO1与SDO2 | SDO1与SDO2 | 3.3V | 独立固件 | 仅被选中的器件驱动总线
H3-4 | B13 | PMW3901 CS | CS / NCS | — | — | 3.3V | 独立固件 | 低有效
H3-5 | F20 | BMI0 ACC CS | — | CSB1 / ACC_CS | — | 3.3V | 独立固件 | 低有效
H3-8 | F19 | BMI0 GYRO CS | — | CSB2 / GYRO_CS | — | 3.3V | 独立固件 | 低有效
H3-9 | C20 | BMI1 ACC CS | — | — | CSB1 / ACC_CS | 3.3V | 独立固件 | 低有效
H3-12 | E19 | BMI1 GYRO CS | — | — | CSB2 / GYRO_CS | 3.3V | 独立固件 | 低有效
H3-13 | VCC | 传感器电源 | VCC / 3V3 | VCC / VDDIO | VCC / VDDIO | 必须先实测约3.3V | 需实测 | 不允许给5V
H3-14 | GND | 公共地 | GND | GND | GND | 0V | 必接 | 所有传感器与FPGA共地
不接 | — | 中断/使能 | INT不接；EN初期悬空 | 全部INT不接 | 全部INT不接 | — | 可选 | BMI模块拨码/焊桥设置为SPI
机械安装 | — | 安装要求 | 镜头朝下且视野无遮挡 | 靠近车体中心、轴向一致 | 靠近车体中心、轴向一致 | — | 必接 | 两块BMI不能镜像或旋转90度安装

Sheet: UWB预留
四标签四基站UWB规划接线（尚未集成）
设备/位置 | PG3.9针脚 | 信号 | FPGA预留接口 | FPGA封装脚 | 方向 | 供电/电平 | 状态 | 备注
TAG1 左前 | pin 6 | TXD | H3-17 | C15 | TAG1 → FPGA | 先测空闲高电平 | 预留/未集成 | 标签ID建议设为1
TAG2 右前 | pin 6 | TXD | H3-18 | E16 | TAG2 → FPGA | 先测空闲高电平 | 预留/未集成 | 标签ID建议设为2
TAG3 左后 | pin 6 | TXD | H3-19 | D14 | TAG3 → FPGA | 先测空闲高电平 | 预留/未集成 | 标签ID建议设为3
TAG4 右后 | pin 6 | TXD | H3-20 | D15 | TAG4 → FPGA | 先测空闲高电平 | 预留/未集成 | 标签ID建议设为4
四个标签 | pin 1 | 5V | 外部5V母线 | — | 供电 | 稳定5V | 预留/未集成 | 不得接H3 VCC
四个标签 | pin 2或pin 7 | GND | H3-15或外部地汇流点 | GND | 公共参考地 | 0V | 预留/未集成 | 标签与FPGA必须共地
四个标签 | pin 4 | RXD | 暂不连接 | — | FPGA → 标签 | TTL | 预留/未集成 | 初期通过USB配置，不接FPGA TX
四个标签 | pin 3/5/8 | SWD DIO/CLK、BOOT0 | 不连接 | — | — | — | 预留/未集成 | 正常运行不接
四个标签 | 天线座 | UWB天线 | 不接FPGA | — | 无线 | 上电前安装天线 | 必接 | 禁止未装天线进行长期工作
基站A | 5V/GND/天线 | 主基站 | 不接FPGA | — | 无线 | 独立稳定5V | 预留/未集成 | 配置并保存自动启动后只需供电
基站B/C/D | 5V/GND/天线 | 次基站 | 不接FPGA | — | 无线 | 各自独立稳定5V | 预留/未集成 | 基站不需要与小车共地
标签TXD检查 | pin 6对GND | 空闲高电平 | 万用表/示波器测量 | — | 测量 | 约3.3V可直连；接近5V必须电平转换 | 警告 | 四路TX绝对不能并接在一起

Sheet: 供电与安全
供电、共地与逻辑电平检查表
设备 | 建议供电 | 是否与FPGA共地 | 进入FPGA的逻辑电平 | 禁止事项 | 核对要点
FPGA板 | 板卡原有电源输入 | 基准地 | 3.3V LVCMOS33 | 不要反向从扩展口供电 | 先确认板卡电源稳定
C5底盘和电机 | 底盘原电池/电机驱动电源 | 是 | 回传若连接必须≤3.3V | 电机电流不得经过FPGA地线杜邦线 | 控制信号地在配电点共地
RPLIDAR C1 | 独立稳定5V | 是 | TXD进入FPGA必须≤3.3V | 不要从H2/H3/H4 VCC供电 | 启动时观察5V是否下跌
超声波模块 | 按模块规格，常见为5V | 是 | ECHO必须≤3.3V | 5V ECHO不可直连D21 | 使用分压器或电平转换
PMW3901 + BMI088 | 稳定3.3V | 是 | 所有SPI均为3.3V | 禁止接5V | 先测H3-13对H3-14电压
四个UWB标签 | 外部稳定5V母线 | 是 | TXD实测后决定是否转换 | 不得使用H3 VCC；四路TX不可并接 | 预留足够电流余量并加近端去耦
四个UWB基站 | 各自稳定5V/USB | 否 | 不接FPGA | 不要遗漏天线 | 固定位置并保存坐标配置
HDMI屏幕 | 屏幕额定独立电源 | 通过HDMI提供信号参考 | TMDS走板载连接器 | 不要从FPGA扩展口供电 | 屏幕供电和HDMI线均应牢固

Sheet: 引脚速查
扩展连接器引脚速查
连接器针脚 | FPGA封装脚 | 当前/规划用途 | 方向 | 代码状态 | 可否复用 | 备注
H1-1 | J6 | 上键 | 输入 | 已生效 | 否 | 低有效
H1-4 | J5 | 下键 | 输入 | 已生效 | 否 | 低有效
H1-5 | E3 | 左键 | 输入 | 已生效 | 否 | 低有效
H1-8 | H3 | 右键 | 输入 | 已生效 | 否 | 低有效
H1-9 | J4 | 中键/确认 | 输入 | 已生效 | 否 | 低有效
H2-11 | J17 | RPLIDAR RXD输入端 | FPGA输出 | 已生效 | 否 | lidar_uart_tx
H2-12 | K17 | RPLIDAR TXD输出端 | FPGA输入 | 已生效 | 否 | lidar_uart_rx
H2-14/15 | GND | 雷达/超声公共地 | 地 | 已生效 | 可共享 | 仅作为信号参考/低电流地
H2-26 | E22 | 超声波TRIG | FPGA输出 | 已生效 | 否 | ultrasonic_trig
H2-27 | D21 | 超声波ECHO | FPGA输入 | 已生效 | 否 | 输入≤3.3V
H3-1 | A14 | 传感器共享SCLK | FPGA输出 | 独立固件 | 主工程当前空闲 | PMW3901+双BMI088
H3-2 | B15 | 传感器共享MOSI | FPGA输出 | 独立固件 | 主工程当前空闲 | PMW3901+双BMI088
H3-3 | A13 | 传感器共享MISO | FPGA输入 | 独立固件 | 主工程当前空闲 | PMW3901+双BMI088
H3-4 | B13 | PMW3901 CS | FPGA输出 | 独立固件 | 主工程当前空闲 | 低有效
H3-5 | F20 | BMI0 ACC CS | FPGA输出 | 独立固件 | 主工程当前空闲 | 低有效
H3-8 | F19 | BMI0 GYRO CS | FPGA输出 | 独立固件 | 主工程当前空闲 | 低有效
H3-9 | C20 | BMI1 ACC CS | FPGA输出 | 独立固件 | 主工程当前空闲 | 低有效
H3-12 | E19 | BMI1 GYRO CS | FPGA输出 | 独立固件 | 主工程当前空闲 | 低有效
H3-13/14 | VCC/GND | 传感器3.3V/地 | 供电 | 独立固件 | 可共享低功耗传感器 | VCC使用前实测
H3-15 | GND | UWB标签公共地 | 地 | 预留/未集成 | 可共享 | 建议经外部地汇流点连接
H3-17 | C15 | UWB TAG1 RX | FPGA输入 | 预留/未集成 | 当前空闲 | 计划接TAG1 TXD
H3-18 | E16 | UWB TAG2 RX | FPGA输入 | 预留/未集成 | 当前空闲 | 计划接TAG2 TXD
H3-19 | D14 | UWB TAG3 RX | FPGA输入 | 预留/未集成 | 当前空闲 | 计划接TAG3 TXD
H3-20 | D15 | UWB TAG4 RX | FPGA输入 | 预留/未集成 | 当前空闲 | 计划接TAG4 TXD
H4-3 | R14 | C5控制TX | FPGA输出 | 已生效 | 否 | 当前底盘控制必接
H4-6 | P15 | C5回传RX | FPGA输入 | 预留/未集成 | 当前可不接 | HDL尚未解析
H4-14/15 | GND | C5公共地 | 地 | 已生效 | 可共享 | 电机大电流不经此针脚
