Wbf200699-rgb/robei_car/docs/experiment_evidence/2026-07-12_c5_mapping/c5_mapping_robei_raw.csv

case | lf_pulse | rf_pulse | lr_pulse | rr_pulse
forward_700 | 2200 | 800 | 2200 | 800
reverse_700 | 800 | 2200 | 800 | 2200
spin_left_650 | 850 | 850 | 850 | 850
spin_right_650 | 2150 | 2150 | 2150 | 2150
wheel_trim_sample | 2150 | 750 | 2300 | 875
