Wbf200699-rgb/robei_car/docs/experiment_evidence/2026-07-12_car_parameters/car_parameter_robei_raw.csv

case | overall | step | lf | rf | lr | rr | lidar_mm
defaults | 700 | 20 | 700 | 700 | 700 | 700 | 450
overall_plus_25 | 725 | 20 | 700 | 700 | 700 | 700 | 450
step_plus_5 | 725 | 25 | 700 | 700 | 700 | 700 | 450
lf_minus_25 | 725 | 25 | 675 | 700 | 700 | 700 | 450
rf_plus_25 | 725 | 25 | 675 | 725 | 700 | 700 | 450
lr_plus_50 | 725 | 25 | 675 | 725 | 750 | 700 | 450
rr_minus_50 | 725 | 25 | 675 | 725 | 750 | 650 | 450
lidar_plus_50 | 725 | 25 | 675 | 725 | 750 | 650 | 500
speed_max | 900 | 25 | 675 | 725 | 750 | 650 | 500
speed_min | 100 | 25 | 675 | 725 | 750 | 650 | 500
lidar_max | 100 | 25 | 675 | 725 | 750 | 650 | 1500
lidar_min | 100 | 25 | 675 | 725 | 750 | 650 | 150
