Wbf200699-rgb/robei_car/c5_timing_results.csv

event | time_ns | value1 | value2 | value3 | value4 | value5
FRAME_DONE | 0 | 0 | 1500 | 1500 | 1500 | 1500 | 0
FRAME_START | 500000210000 | 0 | 3
UART | 500082690000 | 1 | 23 | #
UART | 500169530000 | 2 | 32 | 2
UART | 500256370000 | 3 | 35 | 5
UART | 500343210000 | 4 | 35 | 5
UART | 500430050000 | 5 | 50 | P
UART | 500516890000 | 6 | 44 | D
UART | 500603730000 | 7 | 53 | S
UART | 500690570000 | 8 | 54 | T
UART | 500777410000 | 9 | 21 | !
FRAME_DONE | 500781770000 | 1 | 1500 | 1500 | 1500 | 1500 | 2
FRAME_START | 500781790000 | 1 | 2
UART | 500864270000 | 10 | 23 | #
UART | 500951110000 | 11 | 32 | 2
UART | 501037950000 | 12 | 35 | 5
UART | 501124790000 | 13 | 35 | 5
UART | 501211630000 | 14 | 50 | P
UART | 501298470000 | 15 | 44 | D
UART | 501385310000 | 16 | 53 | S
UART | 501472150000 | 17 | 54 | T
UART | 501558990000 | 18 | 21 | !
FRAME_DONE | 501563350000 | 2 | 1500 | 1500 | 1500 | 1500 | 1
FRAME_START | 501563370000 | 2 | 1
UART | 501645850000 | 19 | 23 | #
UART | 501732690000 | 20 | 32 | 2
UART | 501819530000 | 21 | 35 | 5
UART | 501906370000 | 22 | 35 | 5
UART | 501993210000 | 23 | 50 | P
UART | 502080050000 | 24 | 44 | D
UART | 502166890000 | 25 | 53 | S
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
