Wbf200699-rgb/robei_car/docs/experiment_evidence/2026-07-12_c5_mapping/c5_mapping_key_transitions.csv

time_ps | time_ns | signal | value_bin | value_dec
0 | 0.000 | rst_n | 0 | 0
0 | 0.000 | rr_speed | 0 | 0
0 | 0.000 | rf_speed | 1 | 1
0 | 0.000 | lr_speed | 0 | 0
0 | 0.000 | lf_speed | 0 | 0
0 | 0.000 | force_stop | 1 | 1
0 | 0.000 | c5_bus_tx | 1 | 1
0 | 0.000 | frame_busy | 0 | 0
0 | 0.000 | frame_count | 0 | 0
0 | 0.000 | last_lf_pulse | 10111011100 | 1500
0 | 0.000 | last_lr_pulse | 10111011100 | 1500
0 | 0.000 | last_rf_pulse | 10111011100 | 1500
0 | 0.000 | last_rr_pulse | 10111011100 | 1500
0 | 0.000 | stop_frames_complete | 0 | 0
0 | 0.000 | stop_frames_remaining | 0 | 0
200000 | 200.000 | lr_speed | 1 | 1
230000 | 230.000 | stop_frames_remaining | 11 | 3
250000 | 250.000 | rf_speed | 0 | 0
250000 | 250.000 | frame_busy | 1 | 1
270000 | 270.000 | c5_bus_tx | 0 | 0
8950000 | 8950.000 | c5_bus_tx | 1 | 1
26310000 | 26310.000 | c5_bus_tx | 0 | 0
52350000 | 52350.000 | c5_bus_tx | 1 | 1
61030000 | 61030.000 | c5_bus_tx | 0 | 0
78390000 | 78390.000 | c5_bus_tx | 1 | 1
87110000 | 87110.000 | c5_bus_tx | 0 | 0
104470000 | 104470.000 | c5_bus_tx | 1 | 1
113150000 | 113150.000 | c5_bus_tx | 0 | 0
130510000 | 130510.000 | c5_bus_tx | 1 | 1
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
