Wbf200699-rgb/robei_car/docs/experiment_evidence/2026-07-12_c5_timing/c5_timing_key_transitions.csv

time_ps | time_ns | signal | value_bin | value_dec
0 | 0.000 | rst_n | 0 | 0
0 | 0.000 | rr_speed | 0 | 0
0 | 0.000 | rf_speed | 0 | 0
0 | 0.000 | lr_speed | 0 | 0
0 | 0.000 | lf_speed | 0 | 0
0 | 0.000 | force_stop | 0 | 0
0 | 0.000 | c5_bus_tx | 1 | 1
0 | 0.000 | frame_busy | 0 | 0
0 | 0.000 | frame_count | 0 | 0
0 | 0.000 | last_lf_pulse | 10111011100 | 1500
0 | 0.000 | last_lr_pulse | 10111011100 | 1500
0 | 0.000 | last_rf_pulse | 10111011100 | 1500
0 | 0.000 | last_rr_pulse | 10111011100 | 1500
0 | 0.000 | stop_frames_complete | 0 | 0
0 | 0.000 | stop_frames_remaining | 0 | 0
200000 | 200.000 | rst_n | 1 | 1
500000190000 | 500000190.000 | stop_frames_remaining | 11 | 3
500000210000 | 500000210.000 | frame_busy | 1 | 1
500000230000 | 500000230.000 | c5_bus_tx | 0 | 0
500008910000 | 500008910.000 | c5_bus_tx | 1 | 1
500026270000 | 500026270.000 | c5_bus_tx | 0 | 0
500052310000 | 500052310.000 | c5_bus_tx | 1 | 1
500060990000 | 500060990.000 | c5_bus_tx | 0 | 0
500078350000 | 500078350.000 | c5_bus_tx | 1 | 1
500087070000 | 500087070.000 | c5_bus_tx | 0 | 0
500104430000 | 500104430.000 | c5_bus_tx | 1 | 1
500113110000 | 500113110.000 | c5_bus_tx | 0 | 0
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
