Wbf200699-rgb/robei_car/little_car/source_review/verilog/hdmi_tmds_encoder.v

// =============================================================================
// 模块: hdmi_tmds_encoder
// 作用: 单颜色通道 TMDS 8 bit 到 10 bit 编码器。
// 说明: 消隐期输出控制码；有效期根据输入 1 的数量和 running disparity 选择 XOR/XNOR 与反相。
//
// Robei 源: little_car/model/hdmi_tmds_encoder.model
// 导出范围: 工程登记模块
// 注意: 本文件是通读副本；工程修改仍应同步回 build/*.v 和对应 .model。
// 重生成: python little_car/source_review/export_sources.py
// =============================================================================

module hdmi_tmds_encoder (
  input wire clk_pix,  // HDMI 像素时钟域时钟。
  input wire rst_n,  // 低有效复位；0 清零模块内部状态。
  input wire [7:0] data_in,  // 当前颜色通道待编码的 8 bit 像素字节。
  input wire c0,  // 消隐期 TMDS 控制位 0；蓝色通道连接 hsync。
  input wire c1,  // 消隐期 TMDS 控制位 1；蓝色通道连接 vsync。
  input wire v_de,  // 数据有效选择；1 编码像素数据，0 输出四种控制码之一。
  output reg [9:0] tmds_10b  // 按 running disparity 平衡后的 10 bit TMDS 码字。
);

  // ===========================================================================
  // 模块行为实现
  // ===========================================================================
// -----------------------------------------------------------------------------
// 内部网络、寄存器和计数器
// wire 只承载组合连接；reg 是过程赋值变量，是否保存跨周期状态由其所在时钟/组合过程决定。
// 每条声明后的注释继续说明具体数据含义、单位、编码和更新用途。
// -----------------------------------------------------------------------------
wire [3:0] n1d = data_in[0] + data_in[1] + data_in[2] + data_in[3] +  // 原始输入字节中逻辑 1 的数量。
                 data_in[4] + data_in[5] + data_in[6] + data_in[7];

wire [8:0] q_m;  // 第一阶段 8 bit XOR/XNOR 转换结果。
wire use_xnor = (n1d > 4'd4) || (n1d == 4'd4 && data_in[0] == 1'b0);  // 输入 1 的数量较多时选择 XNOR 链，减少第一阶段码字翻转次数。
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
